metalchesshead/hybrid-synth/anlg1v/anlg1v.kicad_pcb

## KiCad design anlg1v/anlg1v.kicad_pcb (2026-08-13)

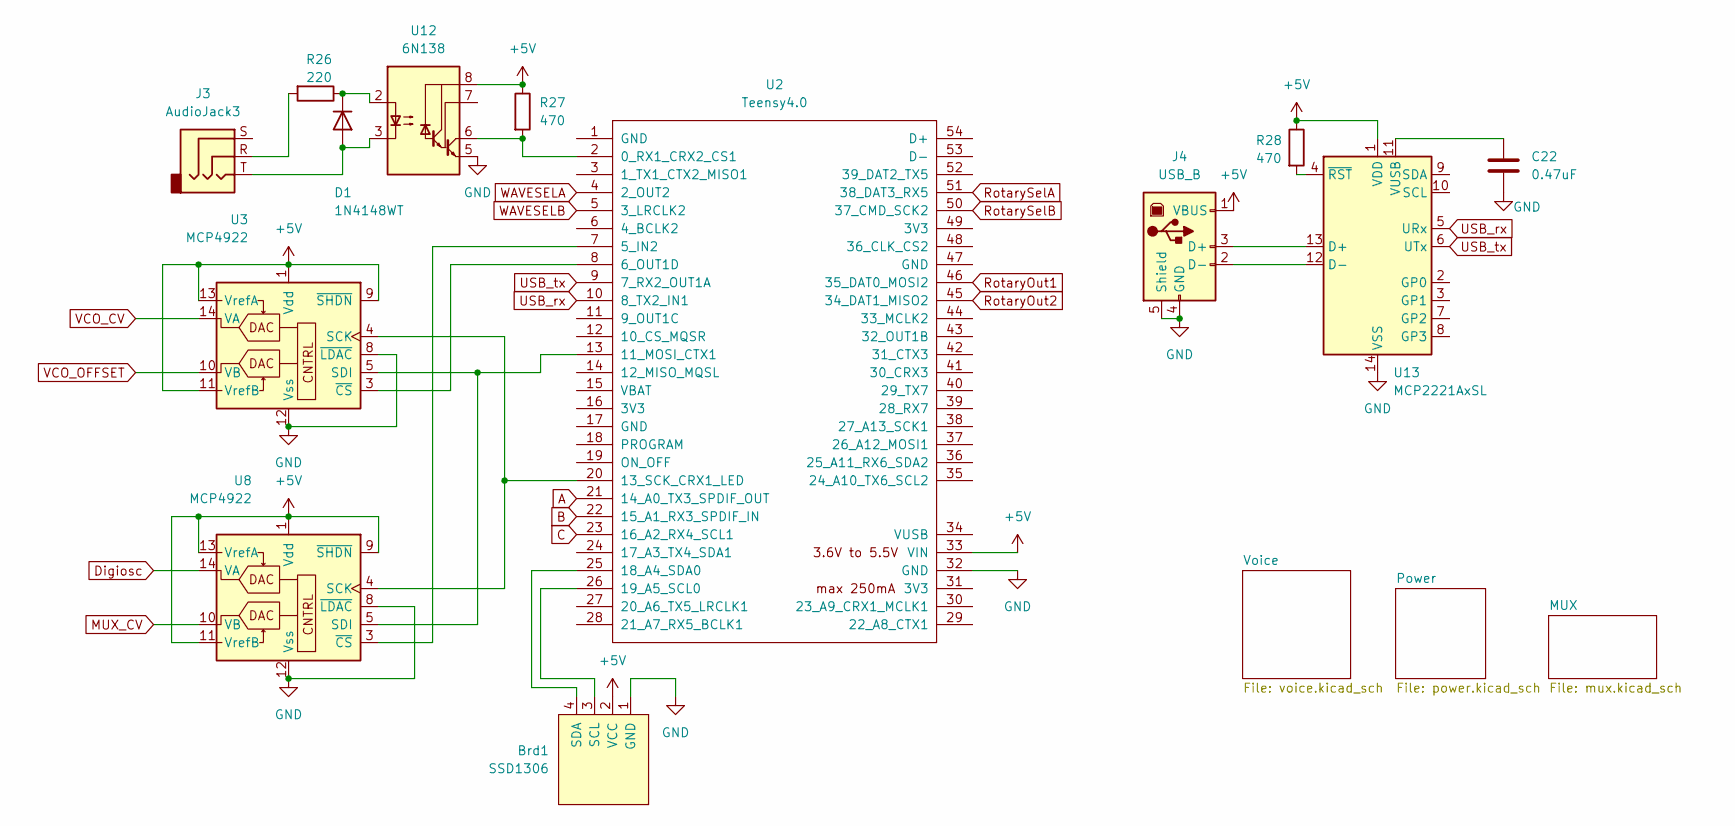
[picture p1: schematic anlg1v.kicad_sch]

Parts:
Brd1: SSD1306; 128x64OLED
C22: 0.47uF; C_0603_1608Metric_Pad1.08x0.95mm_HandSolder
D1: 1N4148WT; D_SOD-523
J3: AudioJack3; PJ-307
J4: USB_B; USB_B_Lumberg_2411_02_Horizontal
R26: 220; R_0603_1608Metric
R27, R28: 470; R_0603_1608Metric
U2: Teensy4.0; Teensy40
U3, U8: MCP4922; SOIC-14_3.9x8.7mm_P1.27mm
U12: 6N138; DIP-8_W7.62mm_Socket
U13: MCP2221AxSL; SOIC-14_3.9x8.7mm_P1.27mm

Connections:
+5V: Brd1.2 (VCC), J4.1 (VBUS), R27.1, R28.1, U2.33 (VIN), U3.1 (Vdd), U3.9 (~SHDN), U3.11 (VrefB), U3.13 (VrefA), U8.1 (Vdd), U8.9 (~SHDN), U8.11 (VrefB), U8.13 (VrefA), U12.8 (VCC), U13.1 (VDD); also elsewhere on the board
A: U2.21 (14_A0_TX3_SPDIF_OUT); also elsewhere on the board
B: U2.22 (15_A1_RX3_SPDIF_IN); also elsewhere on the board
C: U2.23 (16_A2_RX4_SCL1); also elsewhere on the board
Digiosc: U8.14 (VA); also elsewhere on the board
GND: Brd1.1 (GND), C22.2, J4.4 (GND), J4.5 (Shield), U2.32 (GND), U3.8 (~LDAC), U3.12 (Vss), U8.8 (~LDAC), U8.12 (Vss), U12.5 (GND), U13.14 (VSS); also elsewhere on the board
MUX1: U2.24 (17_A3_TX4_SDA1); also elsewhere on the board
MUX2: U2.27 (20_A6_TX5_LRCLK1); also elsewhere on the board
MUX3: U2.28 (21_A7_RX5_BCLK1); also elsewhere on the board
MUX_CV: U8.10 (VB); also elsewhere on the board
unnamed: Brd1.3 (SCL), U2.26 (19_A5_SCL0)
unnamed: Brd1.4 (SDA), U2.25 (18_A4_SDA0)
unnamed: D1.2 (A), J3.T, U12.3 (C2)
unnamed: D1.1 (K), R26.1, U12.2 (C1)
unnamed: J3.R, R26.2
unnamed: J4.3 (D+), U13.13 (D+)
unnamed: J4.2 (D-), U13.12 (D-)
unnamed: U2.7 (5_IN2), U8.3 (~CS)
unnamed: U2.8 (6_OUT1D), U3.3 (~CS)
unnamed: U2.13 (11_MOSI_CTX1), U3.5 (SDI), U8.5 (SDI)
unnamed: U2.20 (13_SCK_CRX1_LED), U3.4 (SCK), U8.4 (SCK)
unnamed: R27.2, U2.2 (0_RX1_CRX2_CS1), U12.6 (VO2)
unnamed: C22.1, U13.11 (VUSB)
unnamed: R28.2, U13.4 (~RST)
RotaryOut1: U2.30 (23_A9_CRX1_MCLK1); also elsewhere on the board
RotaryOut2: U2.29 (22_A8_CTX1); also elsewhere on the board
RotarySelA: U2.11 (9_OUT1C); also elsewhere on the board
RotarySelB: U2.12 (10_CS_MQSR); also elsewhere on the board
USB_rx: U2.10 (8_TX2_IN1), U13.5 (URx)
USB_tx: U2.9 (7_RX2_OUT1A), U13.6 (UTx)
VCO_CV: U3.14 (VA); also elsewhere on the board
VCO_OFFSET: U3.10 (VB); also elsewhere on the board
WAVESELA: U2.4 (2_OUT2); also elsewhere on the board
WAVESELB: U2.5 (3_LRCLK2); also elsewhere on the board

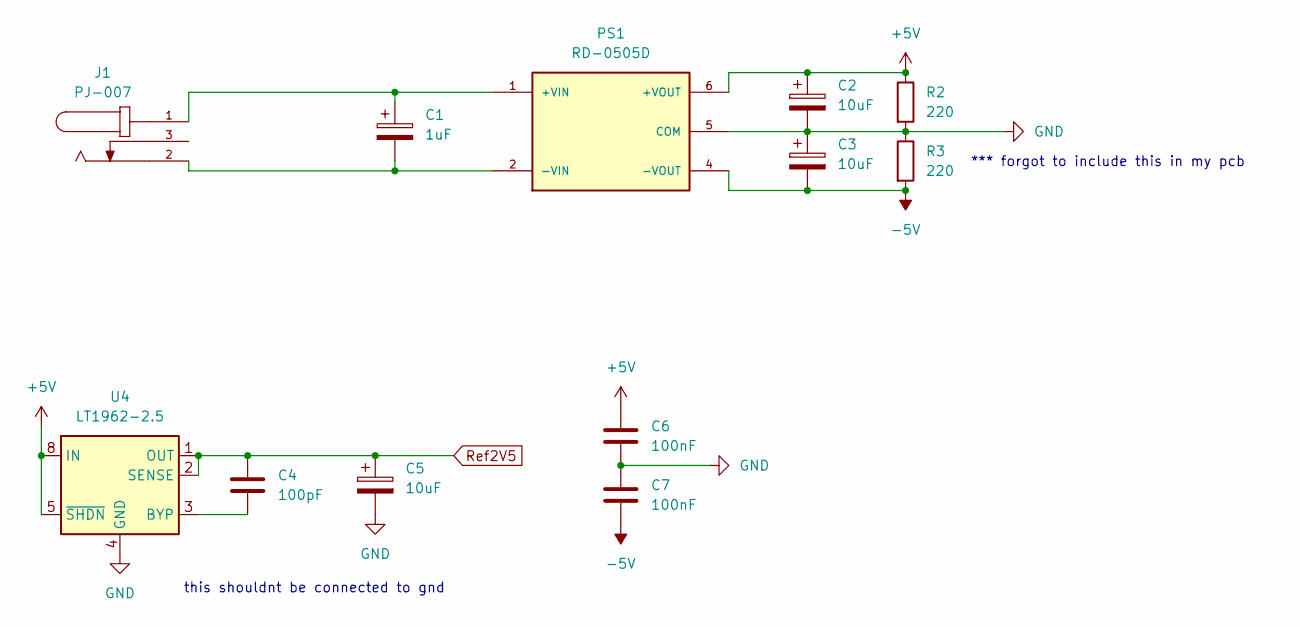
[picture p2: schematic power.kicad_sch]

Parts:
C1: 1uF; CP_Radial_D10.0mm_P5.00mm
C2, C3, C5: 10uF; CP_Radial_D10.0mm_P5.00mm
C4: 100pF; C_0603_1608Metric_Pad1.08x0.95mm_HandSolder
C6, C7: 100nF; C_0603_1608Metric_Pad1.08x0.95mm_HandSolder
J1: PJ-007; SAMESKY_PJ-007; PARTREV 1.07
PS1: RD-0505D; CONV_RD-0505D; PARTREV 1
R2, R3: 220; R_0603_1608Metric
U4: LT1962-2.5; MSOP-8_3x3mm_P0.65mm

Connections:
+5V: C2.1, C6.1, PS1.6 (+VOUT), R2.1, U4.5 (~SHDN), U4.8 (IN); also elsewhere on the board
-5V: C3.2, C7.2, PS1.4 (-VOUT), R3.2; also elsewhere on the board
GND: C2.2, C3.1, C5.2, C6.2, C7.1, PS1.5 (COM), R2.2, R3.1, U4.4 (GND); also elsewhere on the board
unnamed: C1.1, J1.1, PS1.1 (+VIN)
unnamed: C1.2, J1.2, PS1.2 (-VIN)
unnamed: C4.2, U4.3 (BYP)
Ref2V5: C4.1, C5.1, U4.1 (OUT), U4.2 (SENSE); also elsewhere on the board

Notes on the sheet:
*** forgot to include this in my pcb
this shouldnt be connected to gnd

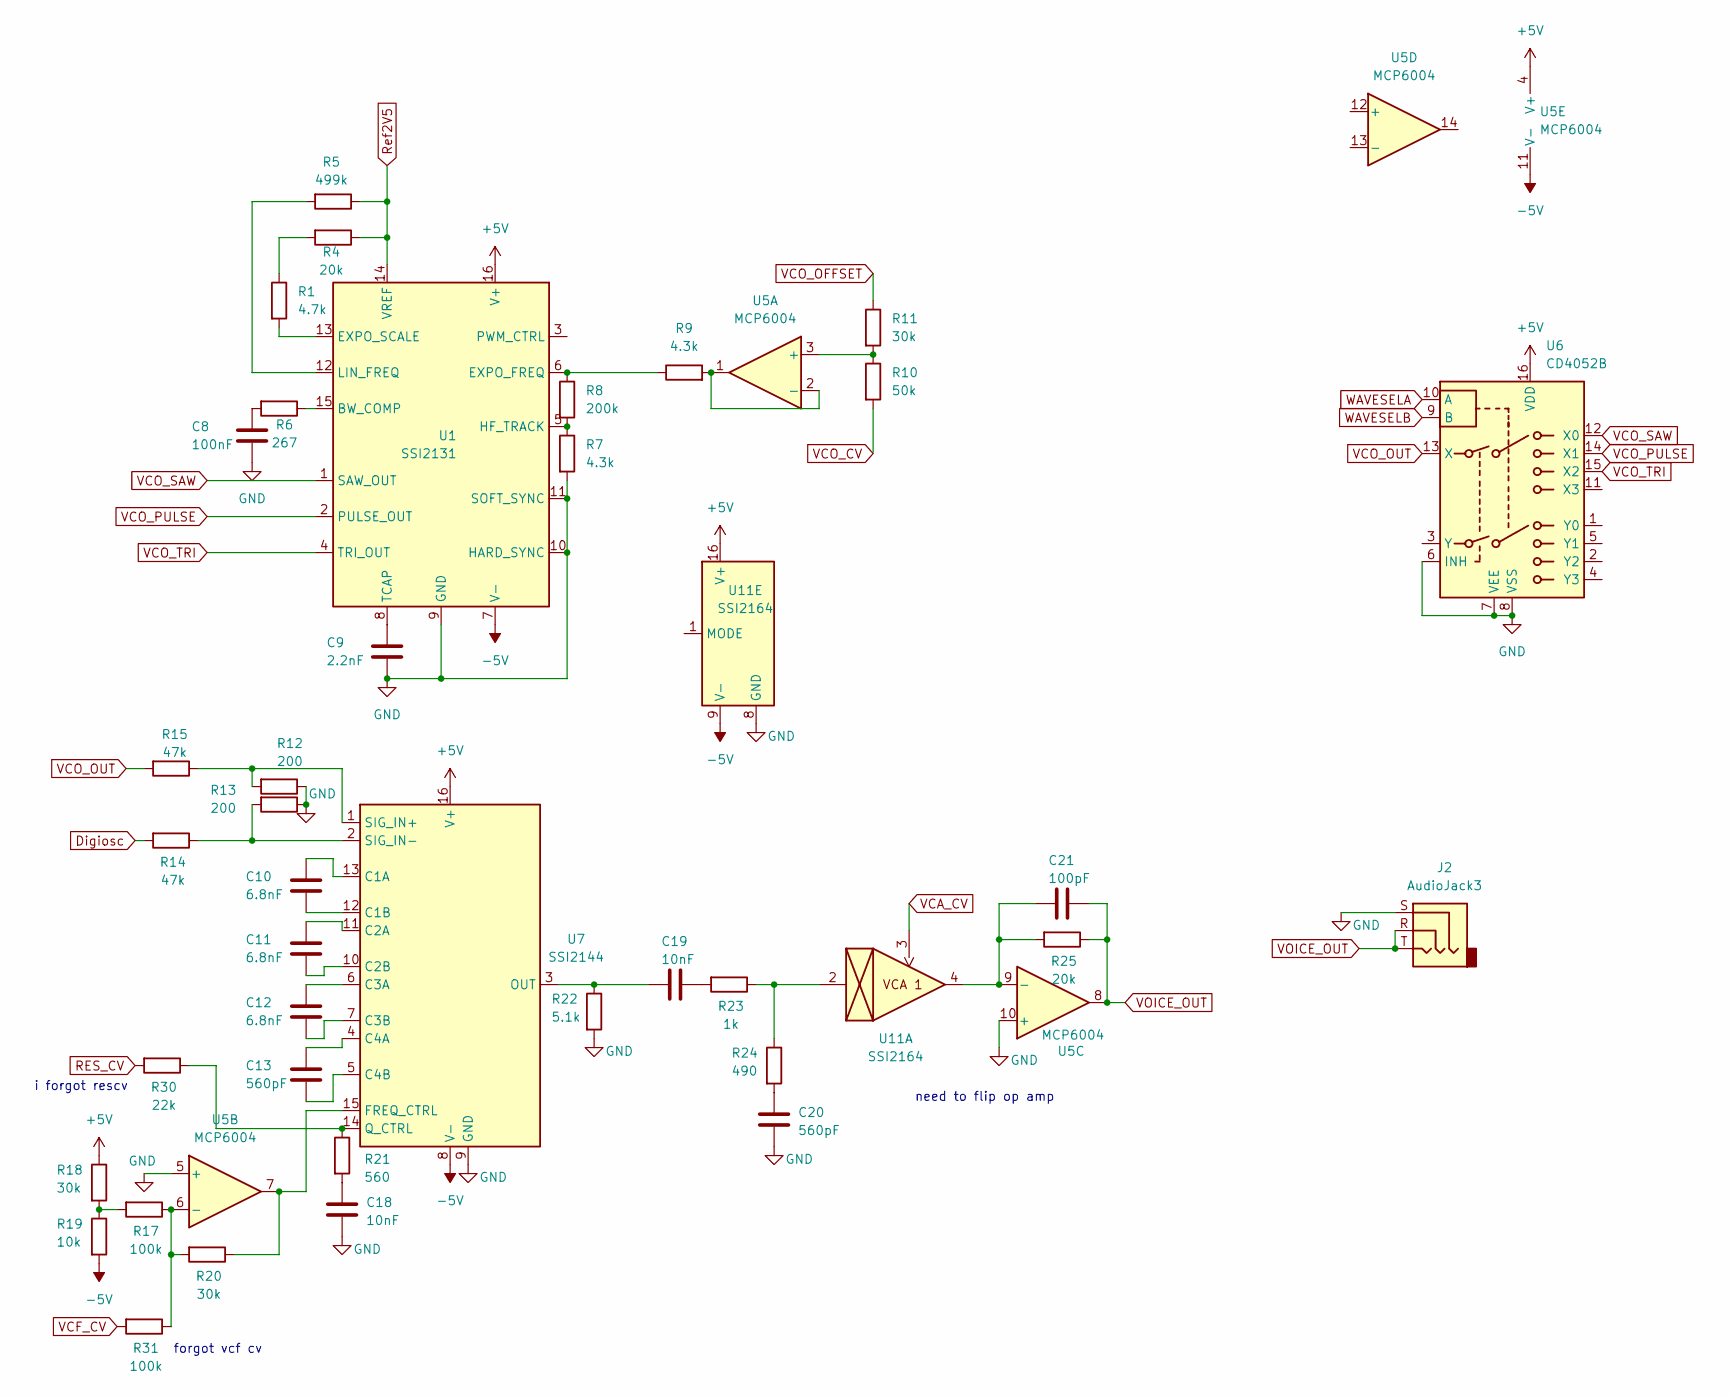
[picture p3: schematic voice.kicad_sch]

Parts:
C8: 100nF; C_0603_1608Metric_Pad1.08x0.95mm_HandSolder
C9: 2.2nF; C_0603_1608Metric_Pad1.08x0.95mm_HandSolder
C10, C11, C12: 6.8nF; C_0603_1608Metric_Pad1.08x0.95mm_HandSolder
C13, C20: 560pF; C_0603_1608Metric_Pad1.08x0.95mm_HandSolder
C18, C19: 10nF; C_0603_1608Metric_Pad1.08x0.95mm_HandSolder
C21: 100pF; C_0603_1608Metric_Pad1.08x0.95mm_HandSolder
J2: AudioJack3; PJ-307
R1: 4.7k; R_0603_1608Metric
R4, R25: 20k; R_0603_1608Metric
R5: 499k; R_0603_1608Metric
R6: 267; R_0603_1608Metric
R7, R9: 4.3k; R_0603_1608Metric
R8: 200k; R_0603_1608Metric
R10: 50k; R_0603_1608Metric
R11, R18, R20: 30k; R_0603_1608Metric
R12, R13: 200; R_0603_1608Metric
R14, R15: 47k; R_0603_1608Metric
R17, R31: 100k; R_0603_1608Metric
R19: 10k; R_0603_1608Metric
R21: 560; R_0603_1608Metric
R22: 5.1k; R_0603_1608Metric
R23: 1k; R_0603_1608Metric
R24: 490; R_0603_1608Metric
R30: 22k; R_0603_1608Metric
U1: SSI2131; STC_SOP-16_3.9x9.9mm_P1.27mm
U5: MCP6004; SOIC-14_3.9x8.7mm_P1.27mm
U6: CD4052B; SOIC-16_3.9x9.9mm_P1.27mm
U7: SSI2144; SSOP-16_3.9x4.9mm_P0.635mm
U11: SSI2164; STC_SOP-16_3.9x9.9mm_P1.27mm

Connections:
+5V: R18.1, U1.16 (V+), U5.4 (V+), U6.16 (VDD), U7.16 (V+), U11.16 (V+); also elsewhere on the board
-5V: R19.2, U1.7 (V-), U5.11 (V-), U7.8 (V-), U11.9 (V-); also elsewhere on the board
Digiosc: R14.2; also elsewhere on the board
GND: C8.2, C9.2, C18.2, C20.2, J2.S, R7.2, R12.1, R13.1, R22.2, U1.9 (GND), U1.10 (HARD_SYNC), U1.11 (SOFT_SYNC), U5.5 (+), U5.10 (+), U6.6 (INH), U6.7 (VEE), U6.8 (VSS), U7.9 (GND), U11.8 (GND); also elsewhere on the board
unnamed: C8.1, R6.2
unnamed: C18.1, R21.2
unnamed: C19.2, R23.2
unnamed: C20.1, R24.2
unnamed: R1.1, R4.2
unnamed: R17.2, R18.2, R19.1
unnamed: R23.1, R24.1, U11.2
unnamed: R6.1, U1.15 (BW_COMP)
unnamed: R8.1, R9.1, U1.6 (EXPO_FREQ)
unnamed: R1.2, U1.13 (EXPO_SCALE)
unnamed: R7.1, R8.2, U1.5 (HF_TRACK)
unnamed: R5.2, U1.12 (LIN_FREQ)
unnamed: C9.1, U1.8 (TCAP)
unnamed: R10.1, R11.2, U5.3 (+)
unnamed: R9.2, U5.1, U5.2 (-)
unnamed: R17.1, R20.2, R31.1, U5.6 (-)
unnamed: C21.1, R25.2, U5.9 (-), U11.4
unnamed: C10.1, U7.13 (C1A)
unnamed: C10.2, U7.12 (C1B)
unnamed: C11.1, U7.11 (C2A)
unnamed: C11.2, U7.10 (C2B)
unnamed: C12.1, U7.6 (C3A)
unnamed: C12.2, U7.7 (C3B)
unnamed: C13.1, U7.4 (C4A)
unnamed: C13.2, U7.5 (C4B)
unnamed: R20.1, U5.7, U7.15 (FREQ_CTRL)
unnamed: C19.1, R22.1, U7.3 (OUT)
unnamed: R21.1, R30.1, U7.14 (Q_CTRL)
unnamed: R12.2, R15.1, U7.1 (SIG_IN+)
unnamed: R13.2, R14.1, U7.2 (SIG_IN-)
RES_CV: R30.2; also elsewhere on the board
Ref2V5: R4.1, R5.1, U1.14 (VREF); also elsewhere on the board
VCA_CV: U11.3; also elsewhere on the board
VCF_CV: R31.2; also elsewhere on the board
VCO_CV: R10.2; also elsewhere on the board
VCO_OFFSET: R11.1; also elsewhere on the board
VCO_OUT: R15.2, U6.13 (X)
VCO_PULSE: U1.2 (PULSE_OUT), U6.14 (X1)
VCO_SAW: U1.1 (SAW_OUT), U6.12 (X0)
VCO_TRI: U1.4 (TRI_OUT), U6.15 (X2)
VOICE_OUT: C21.2, J2.R, J2.T, R25.1, U5.8
WAVESELA: U6.10 (A); also elsewhere on the board
WAVESELB: U6.9 (B); also elsewhere on the board

Notes on the sheet:
forgot vcf cv
need to flip op amp
i forgot rescv

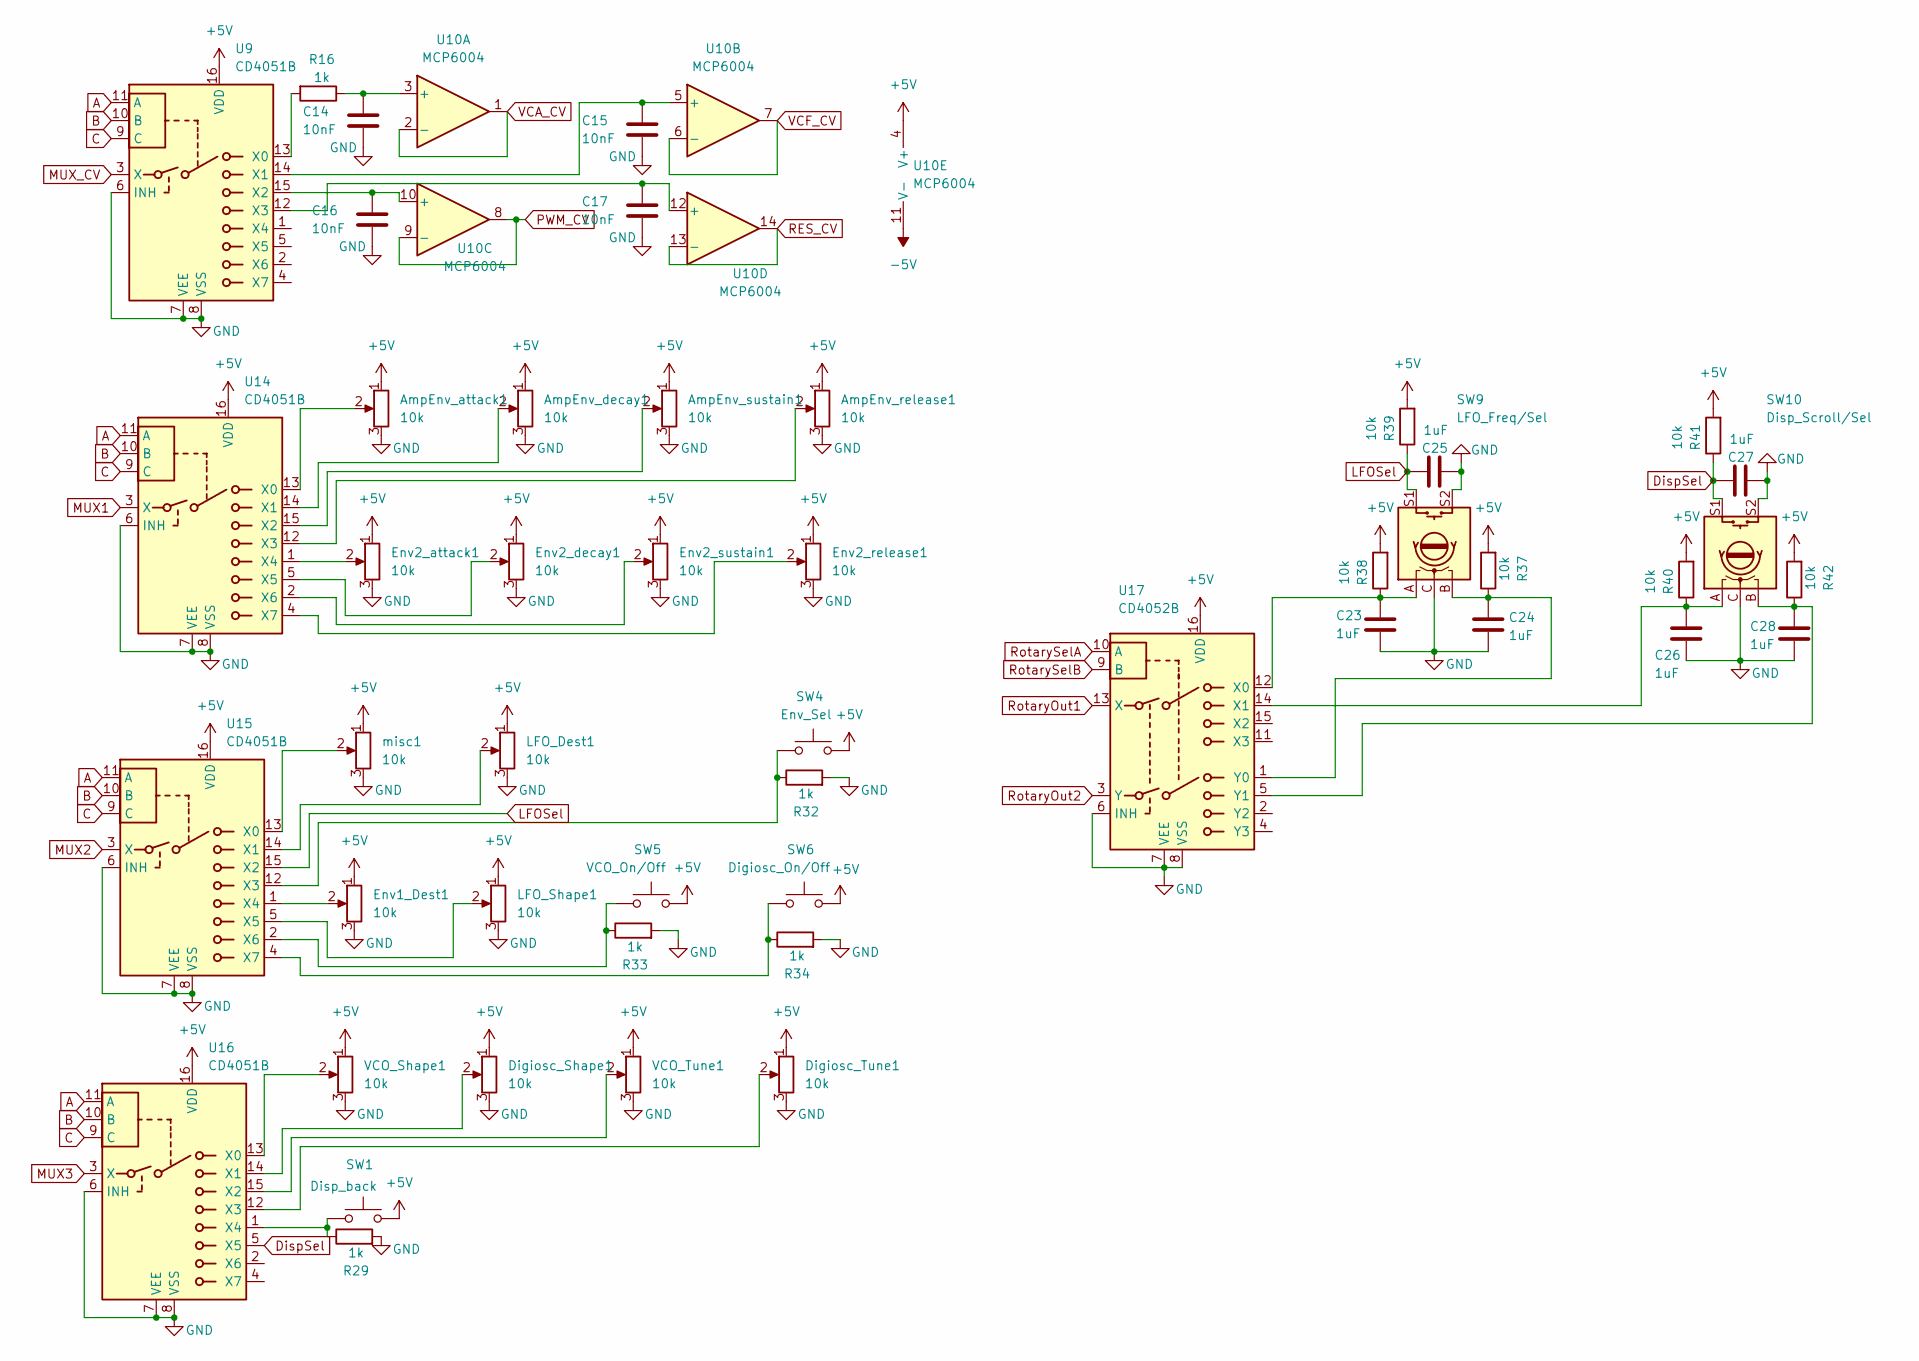
[picture p4: schematic mux.kicad_sch]

Parts:
AmpEnv_attack1: 10k; Potentiometer_Bourns_PTA3043_Single_Slide
AmpEnv_decay1: 10k; Potentiometer_Bourns_PTA3043_Single_Slide
AmpEnv_release1: 10k; Potentiometer_Bourns_PTA3043_Single_Slide
AmpEnv_sustain1: 10k; Potentiometer_Bourns_PTA3043_Single_Slide
C14, C15, C16, C17: 10nF; C_0603_1608Metric_Pad1.08x0.95mm_HandSolder
C23, C24, C25, C26, C27, C28: 1uF; C_0603_1608Metric_Pad1.08x0.95mm_HandSolder
Digiosc_Shape1: 10k; Potentiometer_Bourns_PTV09A-1_Single_Vertical
Digiosc_Tune1: 10k; Potentiometer_Bourns_PTV09A-1_Single_Vertical
Env1_Dest1: 10k; Potentiometer_Bourns_PTV09A-1_Single_Vertical
Env2_attack1, Env2_decay1, Env2_release1, Env2_sustain1: 10k; Potentiometer_Bourns_PTA3043_Single_Slide
LFO_Dest1: 10k; Potentiometer_Bourns_PTV09A-1_Single_Vertical
LFO_Shape1: 10k; Potentiometer_Bourns_PTV09A-1_Single_Vertical
R16, R29, R32, R33, R34: 1k; R_0603_1608Metric
R37, R38, R39, R40, R41, R42: 10k; R_0603_1608Metric
SW1: Disp_back; SW_TH_Tactile_Omron_B3F-102x
SW4: Env_Sel; SW_TH_Tactile_Omron_B3F-102x
SW5: VCO_On/Off; SW_TH_Tactile_Omron_B3F-102x
SW6: Digiosc_On/Off; SW_TH_Tactile_Omron_B3F-102x
SW9: LFO_Freq/Sel; RotaryEncoder_Bourns_Vertical_PEC12R-3x17F-Sxxxx
SW10: Disp_Scroll/Sel; RotaryEncoder_Bourns_Vertical_PEC12R-3x17F-Sxxxx
U9, U14, U15, U16: CD4051B; SOIC-16_3.9x9.9mm_P1.27mm
U10: MCP6004; SOIC-14_3.9x8.7mm_P1.27mm
U17: CD4052B; SOIC-16_3.9x9.9mm_P1.27mm
VCO_Shape1: 10k; Potentiometer_Bourns_PTV09A-1_Single_Vertical
VCO_Tune1: 10k; Potentiometer_Bourns_PTV09A-1_Single_Vertical
misc1: 10k; Potentiometer_Bourns_PTV09A-1_Single_Vertical

Connections:
+5V: AmpEnv_attack1.1, AmpEnv_decay1.1, AmpEnv_release1.1, AmpEnv_sustain1.1, Digiosc_Shape1.1, Digiosc_Tune1.1, Env1_Dest1.1, Env2_attack1.1, Env2_decay1.1, Env2_release1.1, Env2_sustain1.1, LFO_Dest1.1, LFO_Shape1.1, R37.2, R38.2, R39.2, R40.2, R41.2, R42.2, SW1.2, SW4.2, SW5.2, SW6.2, U9.16 (VDD), U10.4 (V+), U14.16 (VDD), U15.16 (VDD), U16.16 (VDD), U17.16 (VDD), VCO_Shape1.1, VCO_Tune1.1, misc1.1; also elsewhere on the board
-5V: U10.11 (V-); also elsewhere on the board
A: U9.11 (A), U14.11 (A), U15.11 (A), U16.11 (A); also elsewhere on the board
B: U9.10 (B), U14.10 (B), U15.10 (B), U16.10 (B); also elsewhere on the board
C: U9.9 (C), U14.9 (C), U15.9 (C), U16.9 (C); also elsewhere on the board
DispSel: C27.2, R41.1, SW10.S1, U16.5 (X5)
GND: AmpEnv_attack1.3, AmpEnv_decay1.3, AmpEnv_release1.3, AmpEnv_sustain1.3, C14.2, C15.2, C16.2, C17.2, C23.2, C24.2, C25.1, C26.2, C27.1, C28.2, Digiosc_Shape1.3, Digiosc_Tune1.3, Env1_Dest1.3, Env2_attack1.3, Env2_decay1.3, Env2_release1.3, Env2_sustain1.3, LFO_Dest1.3, LFO_Shape1.3, R29.2, R32.2, R33.2, R34.2, SW9.C, SW9.S2, SW10.C, SW10.S2, U9.6 (INH), U9.7 (VEE), U9.8 (VSS), U14.6 (INH), U14.7 (VEE), U14.8 (VSS), U15.6 (INH), U15.7 (VEE), U15.8 (VSS), U16.6 (INH), U16.7 (VEE), U16.8 (VSS), U17.6 (INH), U17.7 (VEE), U17.8 (VSS), VCO_Shape1.3, VCO_Tune1.3, misc1.3; also elsewhere on the board
LFOSel: C25.2, R39.1, SW9.S1, U15.15 (X2)
MUX1: U14.3 (X); also elsewhere on the board
MUX2: U15.3 (X); also elsewhere on the board
MUX3: U16.3 (X); also elsewhere on the board
MUX_CV: U9.3 (X); also elsewhere on the board
unnamed: R16.2, U9.13 (X0)
unnamed: C14.1, R16.1, U10.3 (+)
unnamed: C15.1, U9.14 (X1), U10.5 (+)
unnamed: C16.1, U9.15 (X2), U10.10 (+)
unnamed: C17.1, U9.12 (X3), U10.12 (+)
unnamed: AmpEnv_attack1.2, U14.13 (X0)
unnamed: AmpEnv_decay1.2, U14.14 (X1)
unnamed: AmpEnv_sustain1.2, U14.15 (X2)
unnamed: AmpEnv_release1.2, U14.12 (X3)
unnamed: Env2_attack1.2, U14.1 (X4)
unnamed: Env2_decay1.2, U14.5 (X5)
unnamed: Env2_sustain1.2, U14.2 (X6)
unnamed: Env2_release1.2, U14.4 (X7)
unnamed: U15.13 (X0), misc1.2
unnamed: LFO_Dest1.2, U15.14 (X1)
unnamed: R32.1, SW4.1, U15.12 (X3)
unnamed: Env1_Dest1.2, U15.1 (X4)
unnamed: LFO_Shape1.2, U15.5 (X5)
unnamed: R33.1, SW5.1, U15.2 (X6)
unnamed: R34.1, SW6.1, U15.4 (X7)
unnamed: U16.13 (X0), VCO_Shape1.2
unnamed: Digiosc_Shape1.2, U16.14 (X1)
unnamed: U16.15 (X2), VCO_Tune1.2
unnamed: Digiosc_Tune1.2, U16.12 (X3)
unnamed: R29.1, SW1.1, U16.1 (X4)
unnamed: C23.1, R38.1, SW9.A, U17.12 (X0)
unnamed: C26.1, R40.1, SW10.A, U17.14 (X1)
unnamed: C24.1, R37.1, SW9.B, U17.1 (Y0)
unnamed: C28.1, R42.1, SW10.B, U17.5 (Y1)
PWM_CV: U10.8, U10.9 (-)
RES_CV: U10.13 (-), U10.14; also elsewhere on the board
RotaryOut1: U17.13 (X); also elsewhere on the board
RotaryOut2: U17.3 (Y); also elsewhere on the board
RotarySelA: U17.10 (A); also elsewhere on the board
RotarySelB: U17.9 (B); also elsewhere on the board
VCA_CV: U10.1, U10.2 (-); also elsewhere on the board
VCF_CV: U10.6 (-), U10.7; also elsewhere on the board

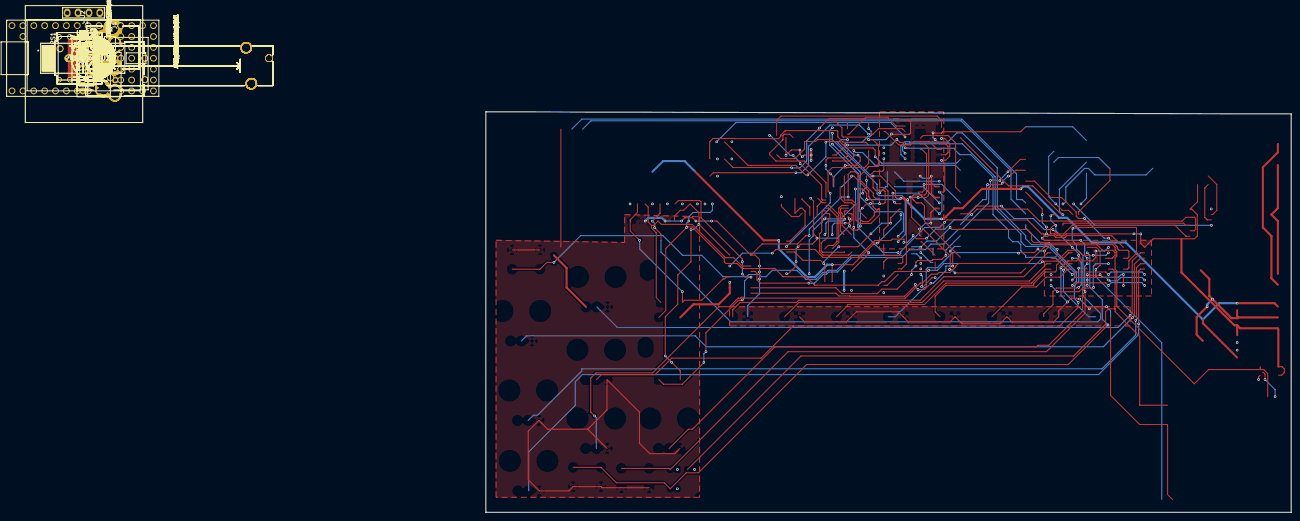
[picture p5: board anlg1v.kicad_pcb from above]

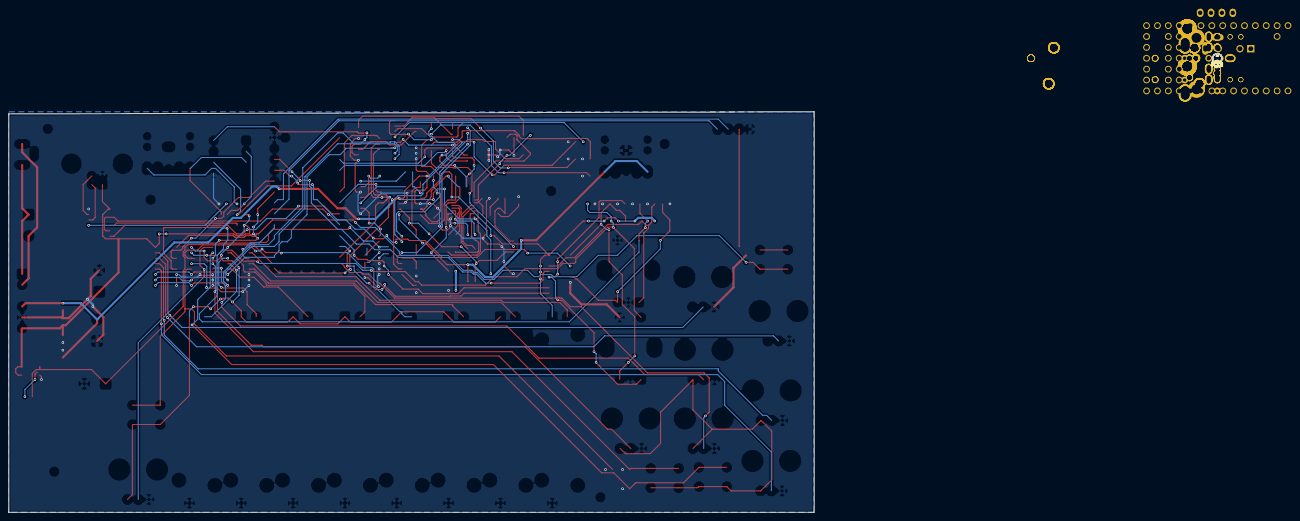
[picture p6: board anlg1v.kicad_pcb from below]

Board: 2 copper layers, 188.0 x 93.5 mm, 114 parts (6 on the bottom side), 109 nets.
