metalchesshead/hybrid-synth/anlg1v/midistuff.cpp

#include "header.h"

float alpha=0.7;
int drive = 0;
double alpha1=0.9;  // initial value for attack
double alpha2=0.9;  // initial value for decay
double alpha3=0.95; // initial value for release
boolean decay = false;
int velocity1= 0;
float freq1;
//int note1;
byte v = 1, w = 1;

void myNoteOn(byte channel, byte note, byte velocity) {
  
  Serial.println(note);
  Serial.println("hi");
 
  //freq = 440.00*(pow(2,((note-69.00)/12.00)));
  

  v = v+1;
   if (v>1){
   
v = 1;
  }
  switch (v) {
    case 1:
    velocity1 = velocity;
    note1 = note; //'- 1;
    freq1 = 440.00*(pow(2,(((note+60.00)-69.00)/12.00)));
    //Serial.println(round(freq1));
    //Serial.println(velocity);
    


    //drive=2701;
    drive=(21*velocity1);
    alpha=alpha1; 
    decay = false;


    break;

  }
}
  
void myNoteOff(byte channel, byte note, byte velocity) {
    //digitalWrite(2, LOW);
  w = w +1;
  if (w>1) {
    w=1;
  }
  switch (w) {
   
    case 1:
    //freq1 = 0;
     
        drive=0;                              // drive towards zero
    alpha=alpha3;                         // set 'time constant' alpha3 for release phase
    

    
    break;

  }
   
}
