metalchesshead/hybrid-synth/(commit log)

2026-05-21 Add initial styles for the board element
2026-06-27 Refactor DAC pin usage and update mux logic
2026-07-07 Refactor velocity handling and update drive values
2026-07-18 Fix border and background styles in #board
2026-07-18 Integrate OLED display and modify pin settings
    Added OLED display support and updated pin configurations.
2026-08-23 Add new buttons for LUT input and upload
2026-10-31 Add UART upload functionality and refactor code
